arrow53/RoomTempHumidity/BaseUnitCase/snapshot-revision-B/enclosed-preview.png

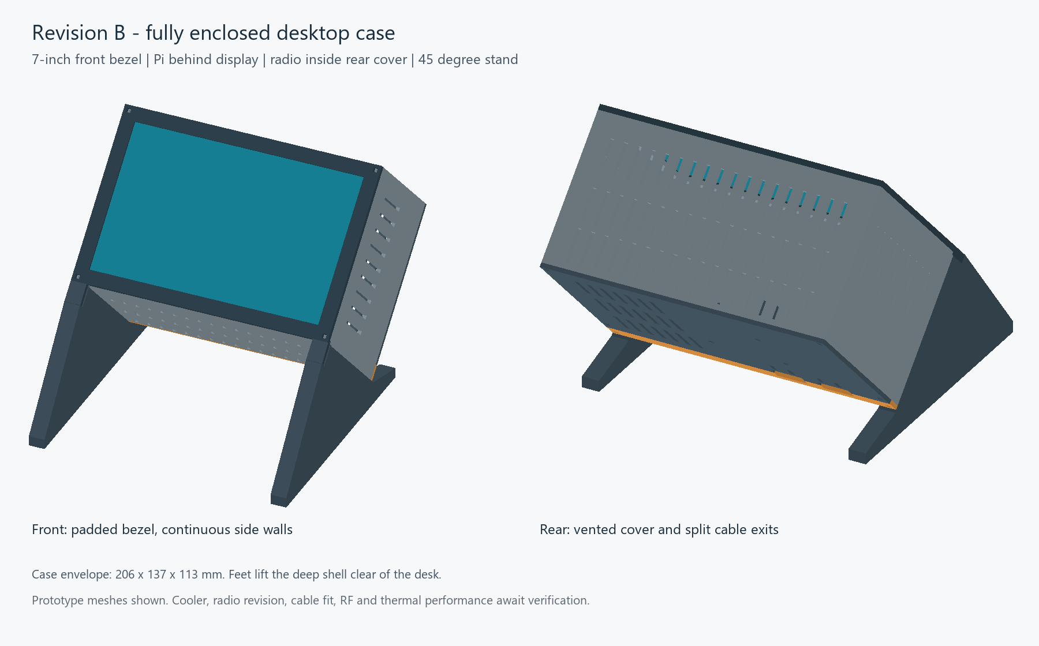
BaseUnitCase/snapshot-revision-B/enclosed-preview.png
