arrow53/RoomTempHumidity/docs/images/sensor-pcb-A3-copper.png

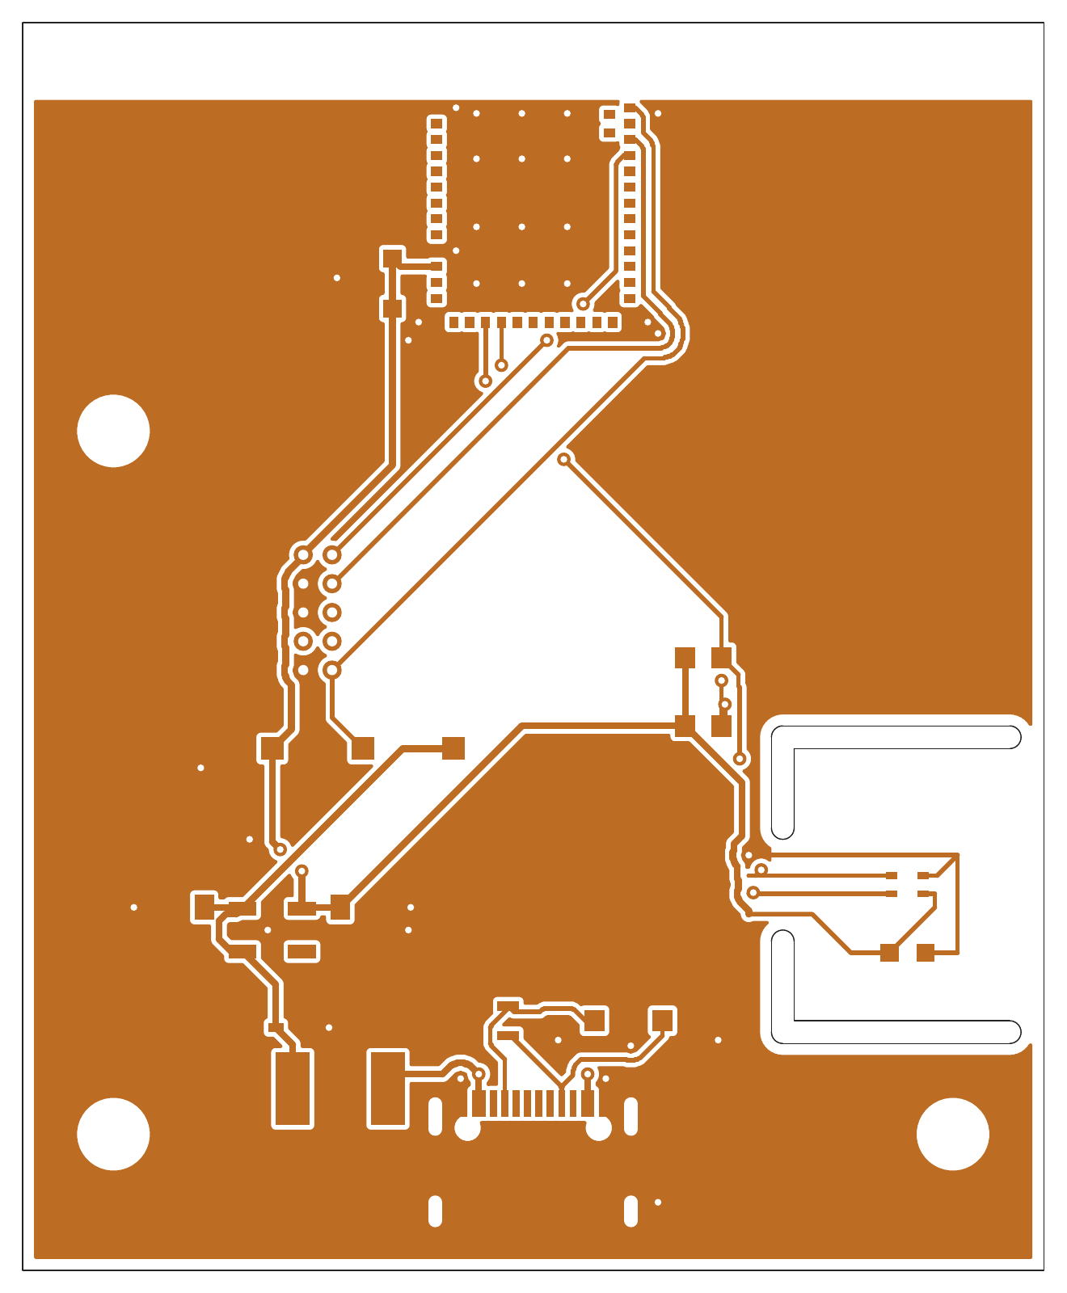
docs/images/sensor-pcb-A3-copper.png
