arrow53/RoomTempHumidity/SensorCase/concept_reference.png

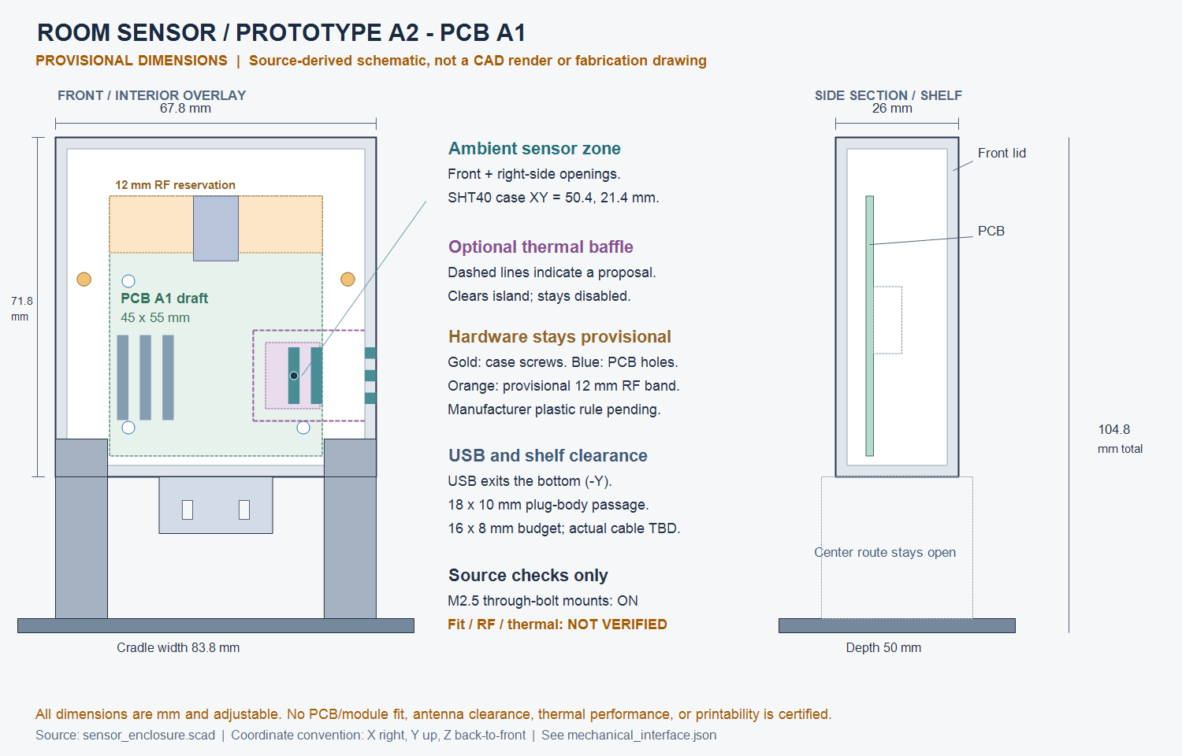
SensorCase/concept_reference.png
