arrow53/RoomTempHumidity/SensorPCB/assembly/BOM-10-boards.csv

Designator | Quantity per board | Quantity for 10 boards | Value / description | Manufacturer | Manufacturer Part Number | Package | Type | Allowed substitutions | Source | Notes
C1 | 1 | 10 | 2.2uF 25V X7R | TDK | C2012X7R1E225K125AB | 0805 | SMT | None; written engineering review required for changes. | https://product.tdk.com/en/search/capacitor/ceramic/mlcc/info?part_no=C2012X7R1E225K125AB | Exact MPN retained after source-based derating screen; see POWER_REVIEW.pdf. First-article startup/transient validation remains.
C2 | 1 | 10 | 4.7uF 10V X7R | TDK | C2012X7R1A475K125AC | 0805 | SMT | None; written engineering review required for changes. | https://product.tdk.com/en/search/capacitor/ceramic/mlcc/info?part_no=C2012X7R1A475K125AC | Exact MPN retained after source-based derating screen; see POWER_REVIEW.pdf. First-article startup/transient validation remains.
C3 | 1 | 10 | 1uF 16V X7R | TDK | C1608X7R1C105K080AC | 0603 | SMT | None; written engineering review required for changes. | https://product.tdk.com/en/search/capacitor/ceramic/mlcc/info?part_no=C1608X7R1C105K080AC | Exact MPN retained after source-based derating screen; see POWER_REVIEW.pdf. First-article startup/transient validation remains.
C4 | 1 | 10 | 100nF 50V X7R | TDK | C1608X7R1H104K080AA | 0603 | SMT | None; written engineering review required for changes. | https://product.tdk.com/en/search/capacitor/ceramic/mlcc/info?part_no=C1608X7R1H104K080AA | Exact MPN retained after source-based derating screen; see POWER_REVIEW.pdf. First-article startup/transient validation remains.
C5 | 1 | 10 | 100nF 50V X7R | TDK | C1608X7R1H104K080AA | 0603 | SMT | None; written engineering review required for changes. | https://product.tdk.com/en/search/capacitor/ceramic/mlcc/info?part_no=C1608X7R1H104K080AA | Exact MPN retained after source-based derating screen; see POWER_REVIEW.pdf. First-article startup/transient validation remains.
D1 | 1 | 10 | TPD1E10B06DYAR | Texas Instruments | TPD1E10B06DYAR | SOD-523 DYA | SMT | None; written engineering review required for changes. | https://www.ti.com/lit/ds/symlink/tpd1e10b06.pdf | 5.5 V standoff; max 14 V clamp at stated 5 A surge test. Verify ESD layout and inrush.
F1 | 1 | 10 | 200mA hold PTC | Bourns | MF-MSMF020-2 | 1812 | SMT | None; written engineering review required for changes. | https://www.bourns.com/docs/product-datasheets/mfmsmf.pdf | 200 mA hold, 30 V; check temperature derating and voltage drop. Not a precise current limiter.
J1 | 1 | 10 | USB4105-GF-A | GCT | USB4105-GF-A | USB-C receptacle, SMT signals plus four plated slotted anchors | SMT + PTH anchors | None; written engineering review required for changes. | https://gct.co/files/drawings/usb4105.pdf | Four common contact pairs use combined pad names; unused data/SBU NC.
R1 | 1 | 10 | 5.1k 1% | YAGEO | RC0603FR-075K1L | 0603 | SMT | None; written engineering review required for changes. | https://yageogroup.com/component-documentation/download/specsheet/RC0603FR-075K1L | USB-C Rd
R2 | 1 | 10 | 5.1k 1% | YAGEO | RC0603FR-075K1L | 0603 | SMT | None; written engineering review required for changes. | https://yageogroup.com/component-documentation/download/specsheet/RC0603FR-075K1L | USB-C Rd
R3 | 1 | 10 | 10k 1% | YAGEO | RC0603FR-0710KL | 0603 | SMT | None; written engineering review required for changes. | https://yageogroup.com/component-documentation/download/specsheet/RC0603FR-0710KL | 100 kHz bus, <=100 pF target
R4 | 1 | 10 | 10k 1% | YAGEO | RC0603FR-0710KL | 0603 | SMT | None; written engineering review required for changes. | https://yageogroup.com/component-documentation/download/specsheet/RC0603FR-0710KL | 100 kHz bus, <=100 pF target
U1 | 1 | 10 | AN54LQ-P15 | Raytac | MD-240A8-002 | 9.5x13.7 mm LGA module, PCB antenna | SMT | MD-240A8-002A or MD-240A8-002R: same AN54LQ-P15, packaging only; no AN54LQ-P10/P05, AN54LV, U15, or preprogrammed AT substitute. | https://www.raytac.com/download/index.php?index_id=74 | Internal LFRC and LDO configuration required. All omitted GPIO, DECD and DCC intentionally NC. Source ten genuine traceable modules; quote feeder attrition separately, not an assumed full tray/reel purchase.
U2 | 1 | 10 | SHT40-AD1B-R3 | Sensirion | SHT40-AD1B-R3 | DFN-4 1.5x1.5 mm | SMT | SHT40-AD1B-R2: same AD1B silicon and 0x44 address, reel quantity only; no -F/-P cover or other grade substitute. | https://sensirion.com/media/documents/33FD6951/6A7C10A0/HT_DS_Datasheet_SHT4x_V7.3.pdf | No central copper pad. No heater during normal measurements.
U3 | 1 | 10 | LT1761-3.3 | Analog Devices | LT1761IS5-3.3#TRMPBF | S5 TSOT-23-5, 1.00 mm max height | SMT | LT1761IS5-3.3#TRPBF, packaging only; genuine Analog Devices only. No E grade, adjustable, voltage or manufacturer substitutions. | https://www.analog.com/en/products/lt1761.html | A3: reverse-current-protected fixed 3.3 V. IN1/GND2/SHDN3/BYP4/OUT5; SHDN tied IN, BYP open. 50 mA design load budget; verify input headroom. Quote/DFM only.
U4 | 1 | 10 | TPD2E2U06DCKR | Texas Instruments | TPD2E2U06DCKR | SC70-3 DCK | SMT | None; written engineering review required for changes. | https://www.ti.com/lit/ds/symlink/tpd2e2u06.pdf | Place next to connector. CC1 and CC2 remain independent.
