arrow53/RoomTempHumidity/SensorPCB/editable/pin-net-review.csv

Reference | Pin | Function | Net
C1 | 1 | 1_1 | /VBUS_FUSED
C1 | 2 | 2_2 | /GND
C2 | 1 | 1_1 | /+3V3
C2 | 2 | 2_2 | /GND
C3 | 1 | 1_1 | /+3V3
C3 | 2 | 2_2 | /GND
C4 | 1 | 1_1 | /+3V3
C4 | 2 | 2_2 | /GND
C5 | 1 | 1_1 | /+3V3
C5 | 2 | 2_2 | /GND
D1 | 1 | IO_1 | /VBUS_FUSED
D1 | 2 | GND_2 | /GND
F1 | 1 | IN_1 | /VBUS_RAW
F1 | 2 | OUT_2 | /VBUS_FUSED
J1 | A1_B12 | GND_A1_B12 | /GND
J1 | A4_B9 | VBUS_A4_B9 | /VBUS_RAW
J1 | A5 | CC1_A5 | /CC1
J1 | A6 | D+_A6 | unconnected-(J1-D+-PadA6)
J1 | A7 | D-_A7 | unconnected-(J1-D--PadA7)
J1 | A8 | SBU1_A8 | unconnected-(J1-SBU1-PadA8)
J1 | B1_A12 | GND_B1_A12 | /GND
J1 | B4_A9 | VBUS_B4_A9 | /VBUS_RAW
J1 | B5 | CC2_B5 | /CC2
J1 | B6 | D+_B6 | unconnected-(J1-D+-PadB6)
J1 | B7 | D-_B7 | unconnected-(J1-D--PadB7)
J1 | B8 | SBU2_B8 | unconnected-(J1-SBU2-PadB8)
J1 | S1 | SHELL_S1 | /GND
J2 | 1 | VTREF_1 | /+3V3
J2 | 10 | RESET_N_10 | /RESET_N
J2 | 2 | SWDIO_2 | /SWDIO
J2 | 3 | GND_3 | /GND
J2 | 4 | SWDCLK_4 | /SWDCLK
J2 | 5 | GND_5 | /GND
J2 | 6 | SWO_NC_6 | unconnected-(J2-SWO_NC-Pad6)
J2 | 7 | KEY_NC_7 | unconnected-(J2-KEY_NC-Pad7)
J2 | 8 | NC_8 | unconnected-(J2-NC-Pad8)
J2 | 9 | GND_DETECT_9 | /GND
R1 | 1 | 1_1 | /CC1
R1 | 2 | 2_2 | /GND
R2 | 1 | 1_1 | /CC2
R2 | 2 | 2_2 | /GND
R3 | 1 | 1_1 | /+3V3
R3 | 2 | 2_2 | /I2C_SCL
R4 | 1 | 1_1 | /+3V3
R4 | 2 | 2_2 | /I2C_SDA
TP1 | 1 | TEST_1 | /GND
TP2 | 1 | TEST_1 | /+3V3
TP3 | 1 | TEST_1 | /RESET_N
TP4 | 1 | TEST_1 | /VBUS_FUSED
U1 | 1 | GND_1 | /GND
U1 | 10 | GND_10 | /GND
U1 | 11 | VDD_NRF_11 | /+3V3
U1 | 12 | P1.00_XL1_12 | unconnected-(U1-P1.00_XL1-Pad12)
U1 | 13 | P1.01_XL2_13 | unconnected-(U1-P1.01_XL2-Pad13)
U1 | 14 | GND_14 | /GND
U1 | 15 | P1.02_NFC1_15 | unconnected-(U1-P1.02_NFC1-Pad15)
U1 | 16 | P1.03_NFC2_16 | unconnected-(U1-P1.03_NFC2-Pad16)
U1 | 17 | P1.04_17 | /I2C_SCL
U1 | 18 | P1.05_18 | /I2C_SDA
U1 | 19 | P1.06_19 | unconnected-(U1-P1.06-Pad19)
U1 | 2 | P1.09_2 | unconnected-(U1-P1.09-Pad2)
U1 | 20 | P1.07_20 | unconnected-(U1-P1.07-Pad20)
U1 | 21 | P1.08_21 | unconnected-(U1-P1.08-Pad21)
U1 | 22 | P2.00_22 | unconnected-(U1-P2.00-Pad22)
U1 | 23 | P2.01_23 | unconnected-(U1-P2.01-Pad23)
U1 | 24 | P2.02_24 | unconnected-(U1-P2.02-Pad24)
U1 | 25 | P2.03_25 | unconnected-(U1-P2.03-Pad25)
U1 | 26 | GND_26 | /GND
U1 | 27 | P2.04_27 | unconnected-(U1-P2.04-Pad27)
U1 | 28 | P2.05_28 | unconnected-(U1-P2.05-Pad28)
U1 | 29 | P2.06_29 | unconnected-(U1-P2.06-Pad29)
U1 | 3 | P1.10_3 | unconnected-(U1-P1.10-Pad3)
U1 | 30 | P2.07_30 | unconnected-(U1-P2.07-Pad30)
U1 | 31 | P2.08_31 | unconnected-(U1-P2.08-Pad31)
U1 | 32 | P2.09_32 | unconnected-(U1-P2.09-Pad32)
U1 | 33 | P2.10_33 | unconnected-(U1-P2.10-Pad33)
U1 | 34 | P0.00_34 | unconnected-(U1-P0.00-Pad34)
U1 | 35 | P0.01_35 | unconnected-(U1-P0.01-Pad35)
U1 | 36 | SWDIO_36 | /SWDIO
U1 | 37 | SWDCLK_37 | /SWDCLK
U1 | 38 | P0.03_38 | unconnected-(U1-P0.03-Pad38)
U1 | 39 | RESET_N_39 | /RESET_N
U1 | 4 | P1.11_4 | unconnected-(U1-P1.11-Pad4)
U1 | 40 | P0.04_40 | unconnected-(U1-P0.04-Pad40)
U1 | 41 | P0.02_41 | unconnected-(U1-P0.02-Pad41)
U1 | 5 | P1.12_5 | unconnected-(U1-P1.12-Pad5)
U1 | 6 | P1.13_6 | unconnected-(U1-P1.13-Pad6)
U1 | 7 | P1.14_7 | unconnected-(U1-P1.14-Pad7)
U1 | 8 | DECD_8 | unconnected-(U1-DECD-Pad8)
U1 | 9 | DCC_9 | unconnected-(U1-DCC-Pad9)
U2 | 1 | SDA_1 | /I2C_SDA
U2 | 2 | SCL_2 | /I2C_SCL
U2 | 3 | VDD_3 | /+3V3
U2 | 4 | VSS_4 | /GND
U3 | 1 | IN_1 | /VBUS_FUSED
U3 | 2 | GND_2 | /GND
U3 | 3 | SHDN_3 | /VBUS_FUSED
U3 | 4 | BYP_4 | unconnected-(U3-BYP-Pad4)
U3 | 5 | OUT_5 | /+3V3
U4 | 1 | IO1_1 | /CC1
U4 | 2 | IO2_2 | /CC2
U4 | 3 | GND_3 | /GND
