arrow53/RoomTempHumidity/BaseUnitCase/revision-C/assembled_enclosure.step

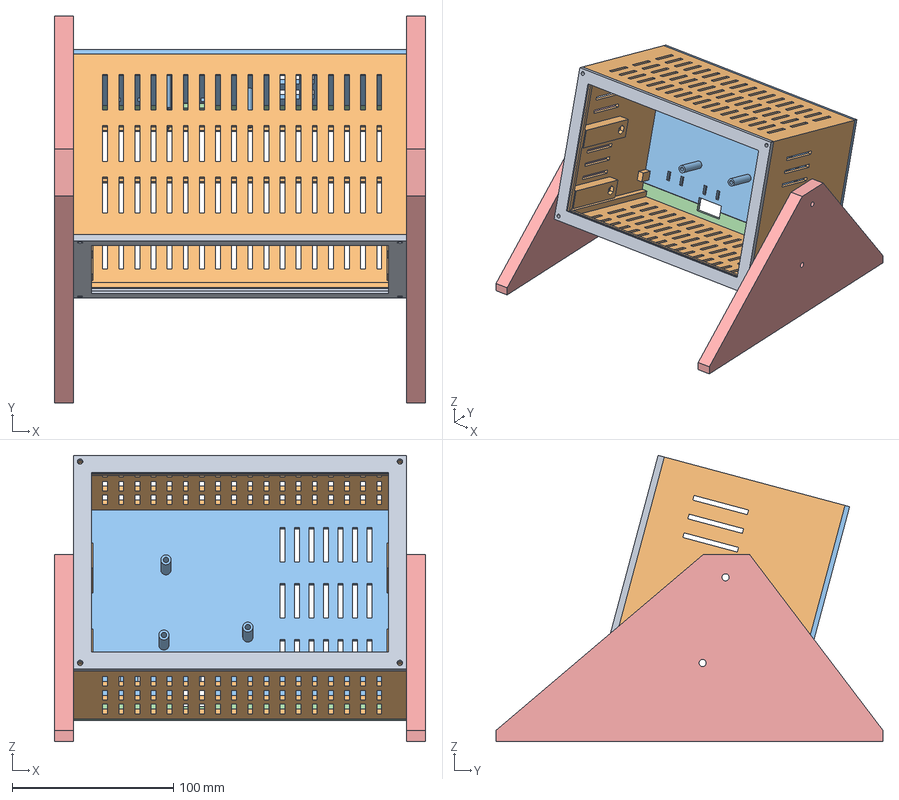
[picture p8: CAD file, 2026-10-11]
BaseUnitCase/revision-C/assembled_enclosure.step
230.3 x 240.0 x 177.6 mm
