arrow53/RoomTempHumidity/BaseUnitCase/revision-C/side_stand_print_two.step

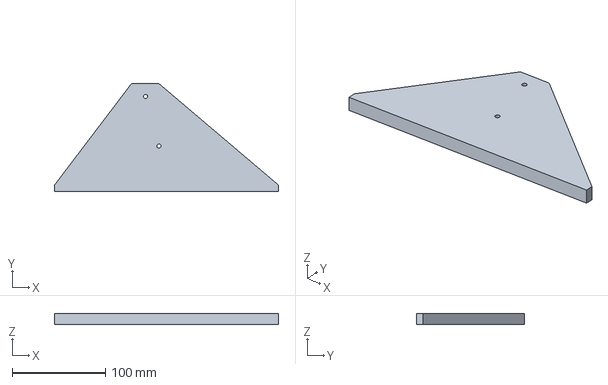
[picture p9: CAD file, 2026-10-11]
BaseUnitCase/revision-C/side_stand_print_two.step
240.0 x 115.9 x 12.0 mm
