arrow53/RoomTempHumidity/BaseUnitCase/snapshot-revision-B/feet_45_print_two.stl

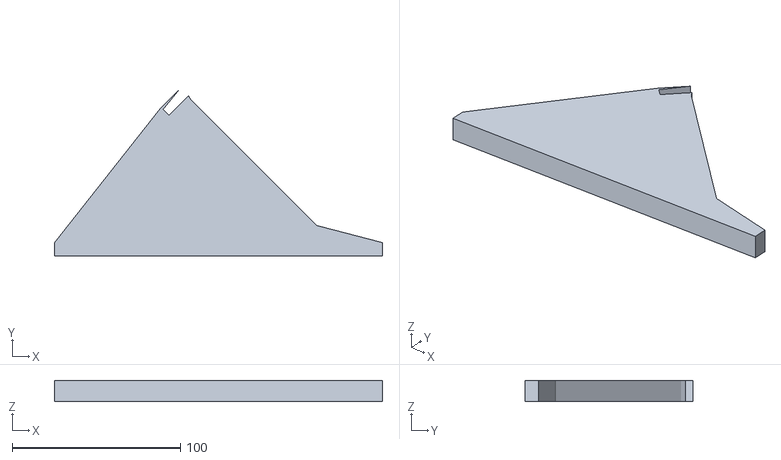
[picture p10: CAD file, 2026-10-11]
BaseUnitCase/snapshot-revision-B/feet_45_print_two.stl
195.0 x 100.0 x 12.6
