arrow53/RoomTempHumidity/SensorCase/fit_coupons/usb_wall_PROVISIONAL.stl

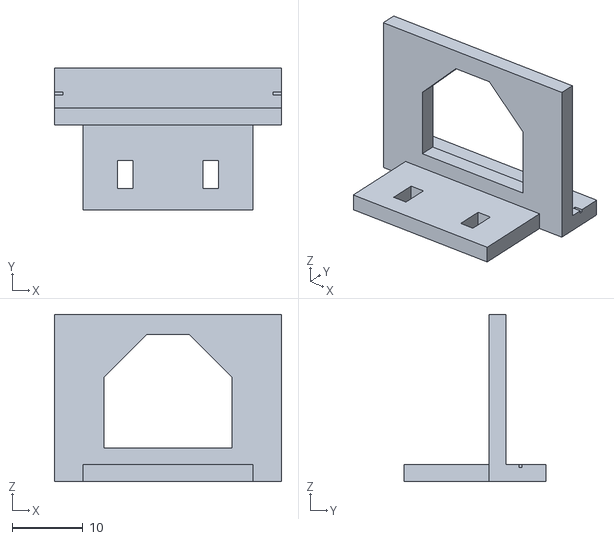
[picture p11: CAD file, 2026-10-11]
SensorCase/fit_coupons/usb_wall_PROVISIONAL.stl
32.0 x 20.0 x 23.6
