arrow53/RoomTempHumidity/SensorCase/provisional_cad/lid_PROVISIONAL.stl

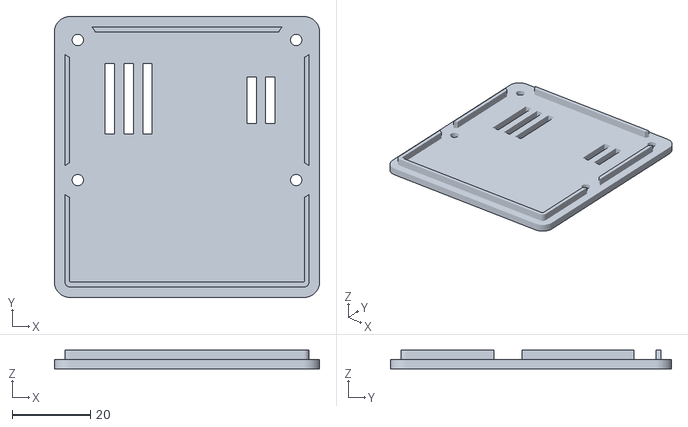
[picture p12: CAD file, 2026-10-11]
SensorCase/provisional_cad/lid_PROVISIONAL.stl
67.8 x 71.8 x 4.80
