arrow53/RoomTempHumidity/BaseUnitCase/revision-C/fastener_coupon.step

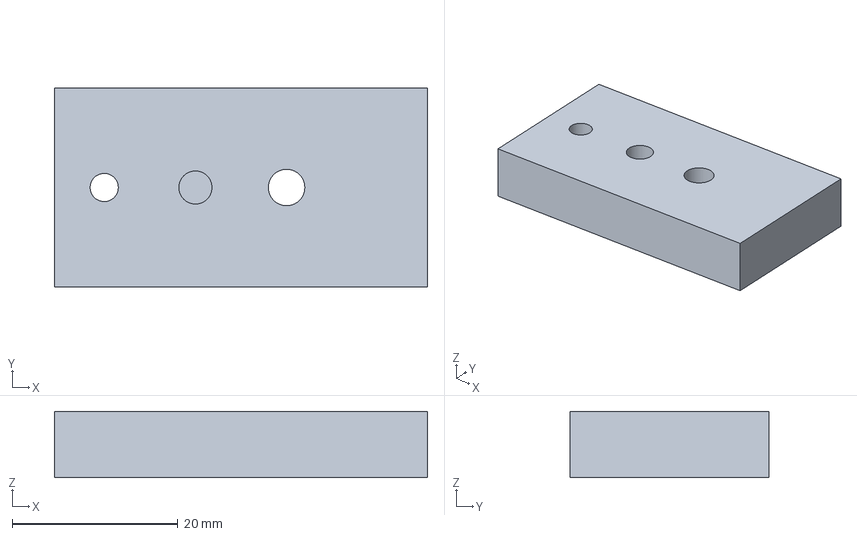
[picture p13: CAD file, 2026-10-11]
BaseUnitCase/revision-C/fastener_coupon.step
45.0 x 24.0 x 8.00 mm
