arrow53/RoomTempHumidity/BaseUnitCase/snapshot-revision-B/rear_cover_radio_mount.stl

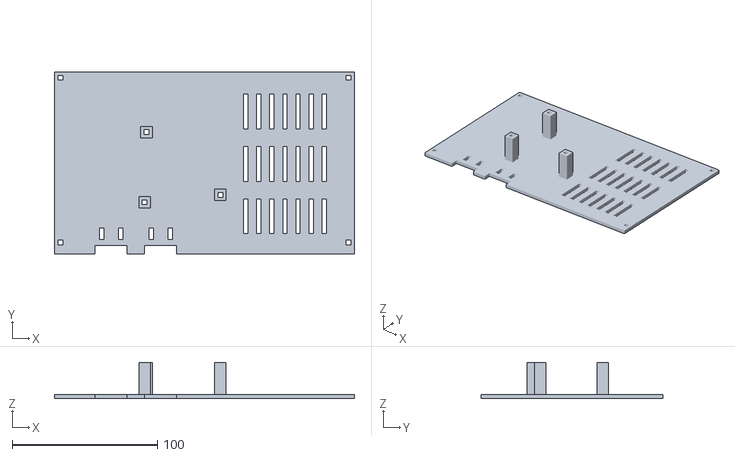
[picture p14: CAD file, 2026-10-11]
BaseUnitCase/snapshot-revision-B/rear_cover_radio_mount.stl
206.3 x 125.2 x 25.0
