arrow53/RoomTempHumidity/SensorCase/fit_coupons/pcb_shim_PROVISIONAL.stl

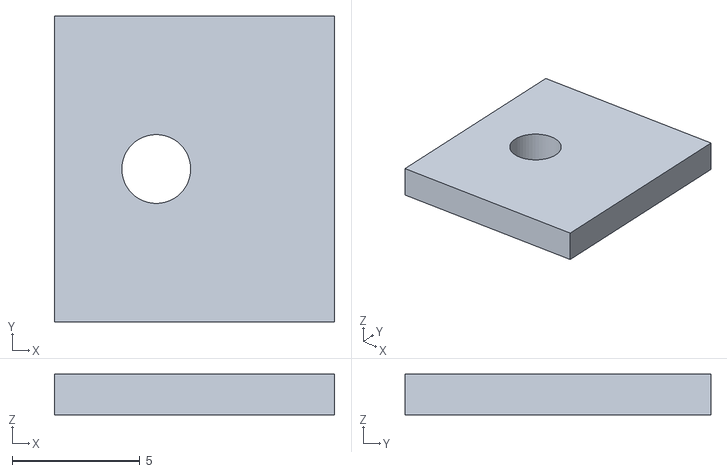
[picture p15: CAD file, 2026-10-11]
SensorCase/fit_coupons/pcb_shim_PROVISIONAL.stl
11.0 x 12.0 x 1.60
