arrow53/RoomTempHumidity/SensorCase/provisional_cad/wall_spacer_PROVISIONAL.stl

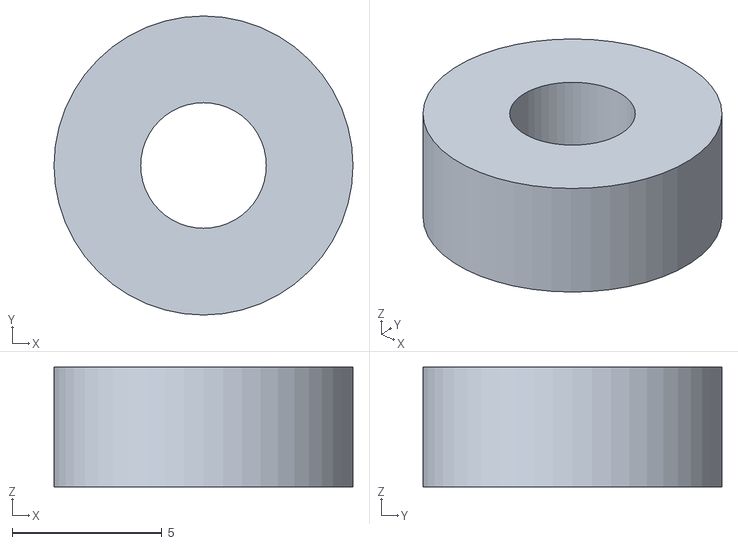
[picture p16: CAD file, 2026-10-11]
SensorCase/provisional_cad/wall_spacer_PROVISIONAL.stl
10.0 x 10.0 x 4.00
