arrow53/RoomTempHumidity/BaseUnitCase/revision-C/hardware_clearance_PROXIES.step

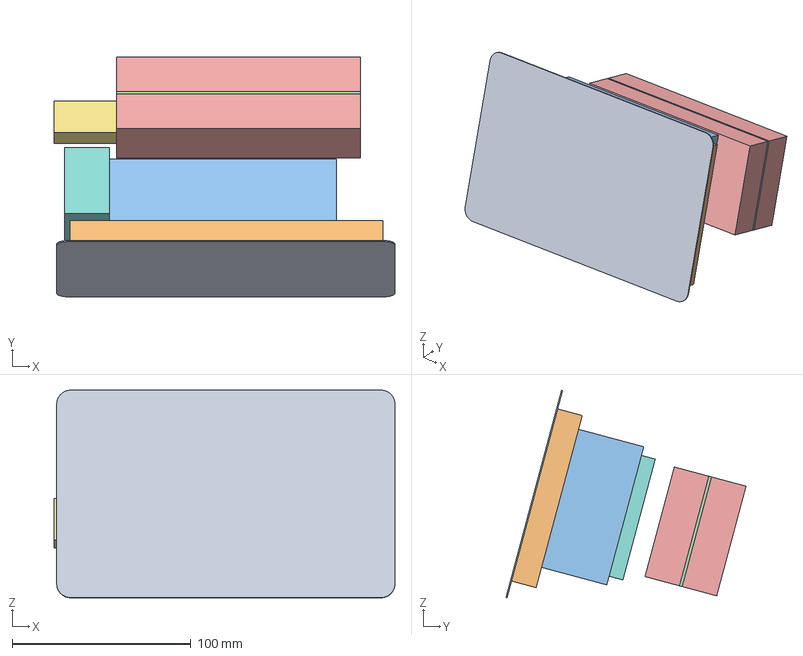
[picture p17: CAD file, 2026-10-11]
BaseUnitCase/revision-C/hardware_clearance_PROXIES.step
190.8 x 134.4 x 116.3 mm
