arrow53/RoomTempHumidity/BaseUnitCase/snapshot-revision-B/rear_cable_strip.stl

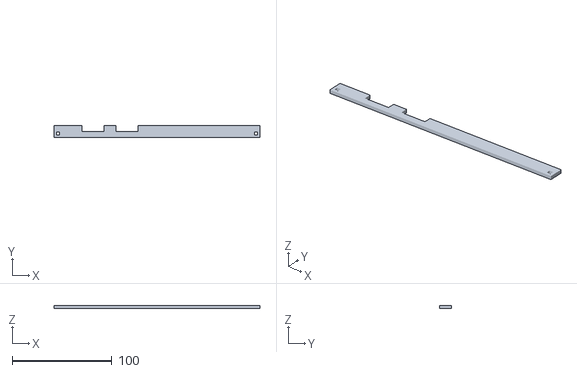
[picture p18: CAD file, 2026-10-11]
BaseUnitCase/snapshot-revision-B/rear_cable_strip.stl
206.3 x 12.0 x 3.00
