arrow53/RoomTempHumidity/SensorCase/fit_coupons/case_lid_PROVISIONAL.stl

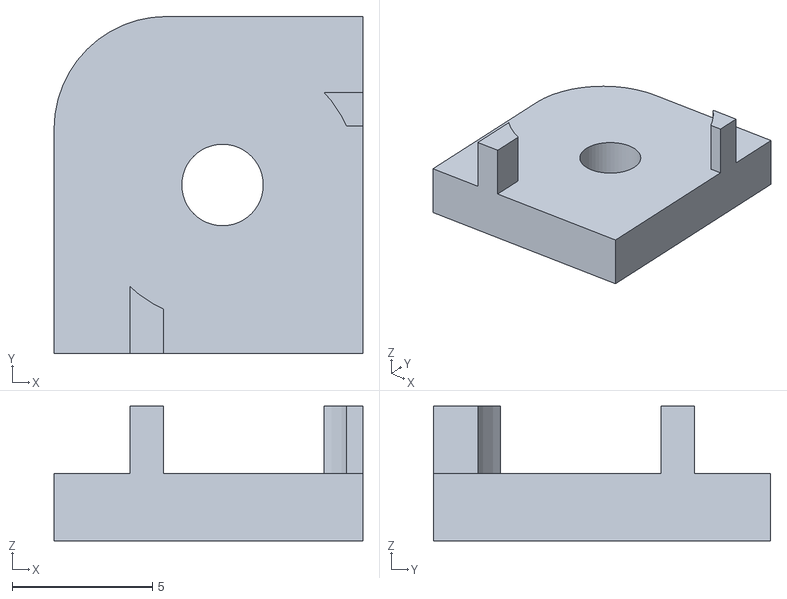
[picture p19: CAD file, 2026-10-11]
SensorCase/fit_coupons/case_lid_PROVISIONAL.stl
11.0 x 12.0 x 4.80
