arrow53/RoomTempHumidity/SensorCase/provisional_cad/stand_PROVISIONAL.stl

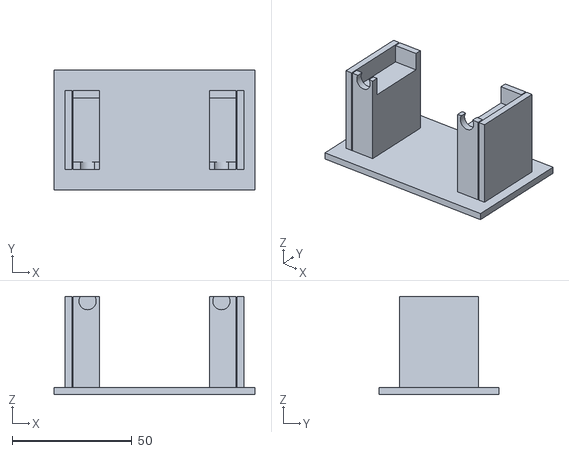
[picture p20: CAD file, 2026-10-11]
SensorCase/provisional_cad/stand_PROVISIONAL.stl
83.8 x 50.0 x 41.0
