arrow53/RoomTempHumidity/BaseUnitCase/revision-C/rear_cover_radio_mount.step

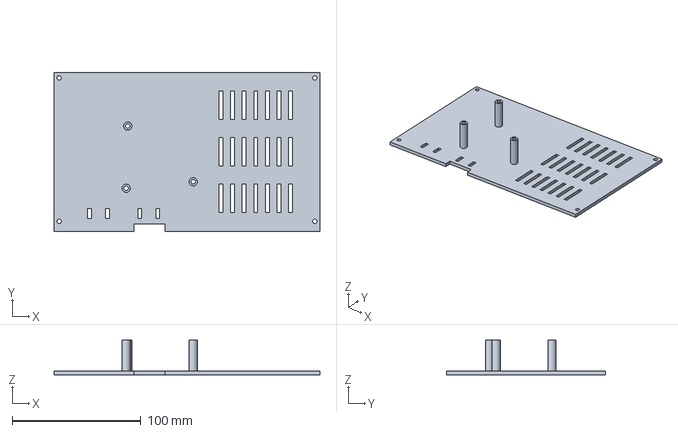
[picture p21: CAD file, 2026-10-11]
BaseUnitCase/revision-C/rear_cover_radio_mount.step
206.3 x 122.9 x 27.0 mm
