arrow53/RoomTempHumidity/BaseUnitCase/snapshot-revision-B/enclosed_body.stl

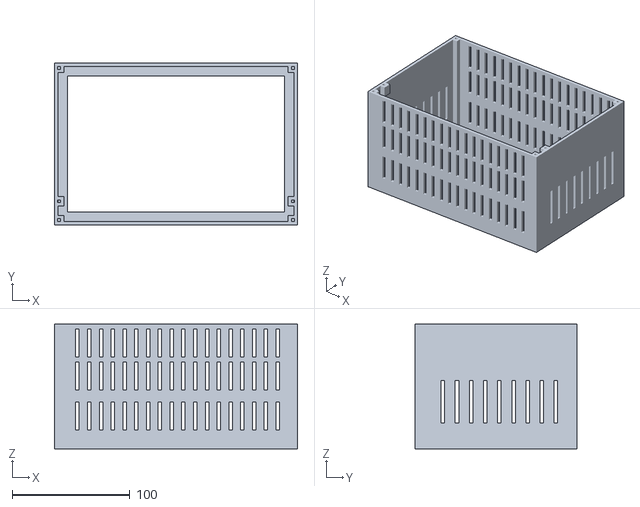
[picture p22: CAD file, 2026-10-11]
BaseUnitCase/snapshot-revision-B/enclosed_body.stl
206.3 x 137.2 x 106.0
