arrow53/RoomTempHumidity/SensorCase/provisional_cad/coupon_PROVISIONAL.stl

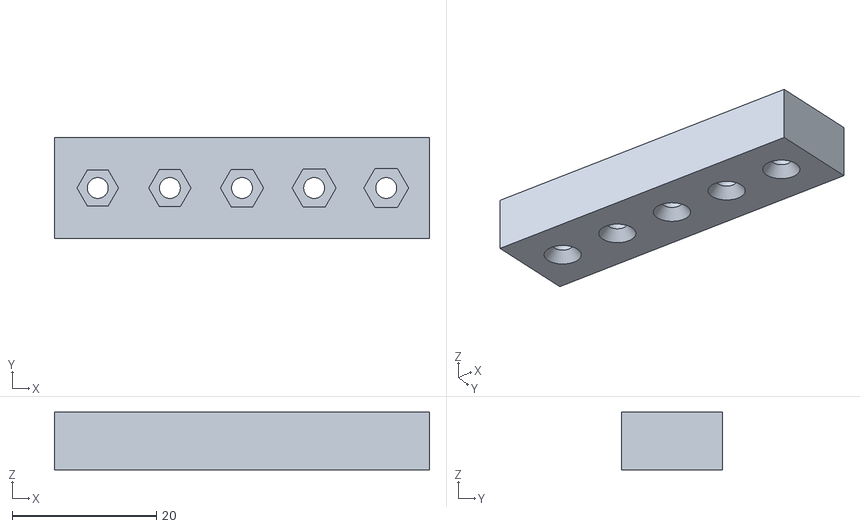
[picture p23: CAD file, 2026-10-11]
SensorCase/provisional_cad/coupon_PROVISIONAL.stl
52.0 x 14.0 x 8.00
