arrow53/RoomTempHumidity/BaseUnitCase/revision-C/front_bezel.step

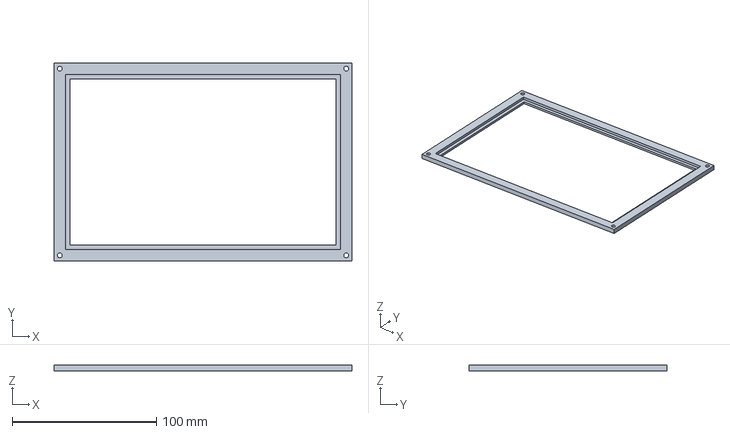
[picture p24: CAD file, 2026-10-11]
BaseUnitCase/revision-C/front_bezel.step
206.3 x 137.2 x 4.00 mm
