arrow53/RoomTempHumidity/BaseUnitCase/snapshot-revision-B/front_bezel.stl

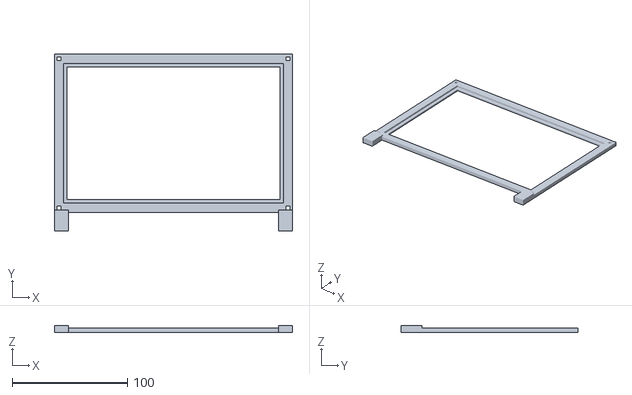
[picture p25: CAD file, 2026-10-11]
BaseUnitCase/snapshot-revision-B/front_bezel.stl
206.3 x 153.2 x 6.00
