arrow53/RoomTempHumidity/SensorCase/provisional_cad/base_PROVISIONAL.stl

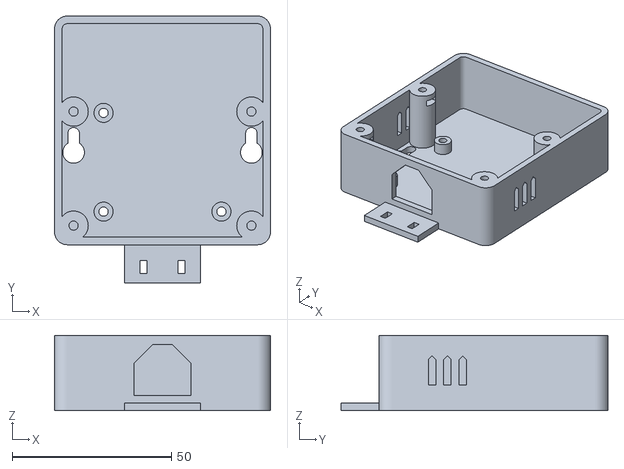
[picture p27: CAD file, 2026-10-11]
SensorCase/provisional_cad/base_PROVISIONAL.stl
67.8 x 83.8 x 23.6
