arrow53/RoomTempHumidity/BaseUnitCase/snapshot-revision-B/fit_coupon.stl

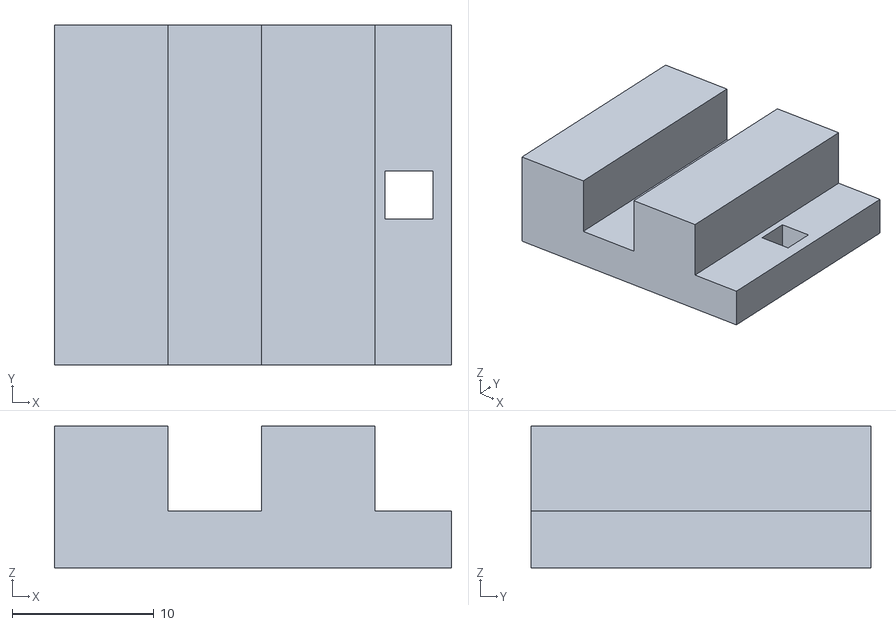
[picture p28: CAD file, 2026-10-11]
BaseUnitCase/snapshot-revision-B/fit_coupon.stl
28.0 x 24.0 x 10.0
