arrow53/RoomTempHumidity/BaseUnitCase/revision-C/vented_body.step

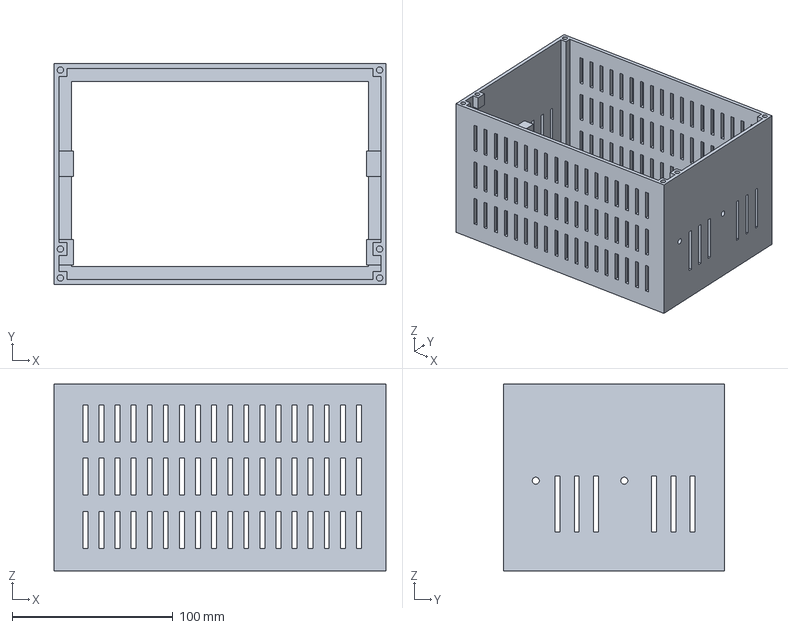
[picture p29: CAD file, 2026-10-11]
BaseUnitCase/revision-C/vented_body.step
206.3 x 137.2 x 116.0 mm
