arrow53/RoomTempHumidity/BaseUnitCase/revision-C/rear_cable_strip.step

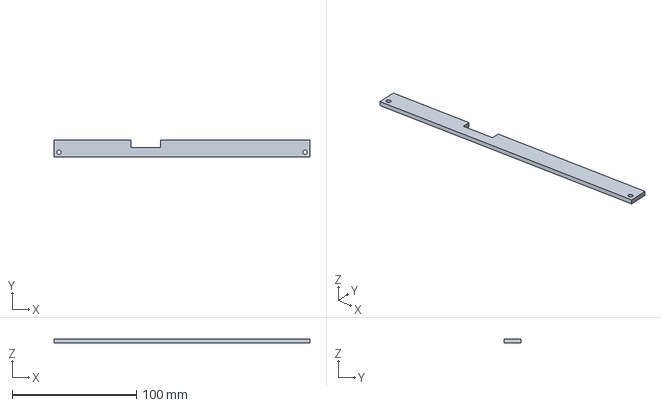
[picture p30: CAD file, 2026-10-11]
BaseUnitCase/revision-C/rear_cable_strip.step
206.3 x 14.0 x 3.00 mm
