arrow53/RoomTempHumidity/BaseUnitCase/snapshot-revision-B/enclosed_case.scad

// Revision B: enclosed, millimetres. Generated by enclosed_case.py
part="assembly";
module front_bezel(){difference(){union(){translate([0, 0, 0]) cube([206.32, 137.24, 4]);translate([0, -16, 0]) cube([12, 18, 6]);translate([194.32, -16, 0]) cube([12.0, 18, 6]);}union(){translate([11, 11, -1]) cube([184.32, 115.24, 8]);translate([8, 8, 1.8]) cube([190.32, 121.24, 8.0]);translate([2.3, 2.3, -1]) cube([3.4, 3.4, 9]);translate([200.62, 2.3, -1]) cube([3.4, 3.4, 9]);translate([2.3, 131.54000000000002, -1]) cube([3.4, 3.4, 9]);translate([200.62, 131.54000000000002, -1]) cube([3.4, 3.4, 9]);}}}
module enclosed_body(){difference(){union(){translate([0, 0, 0]) cube([206.32, 137.24, 3]);translate([0, 0, 0]) cube([3, 137.24, 106.0]);translate([203.32, 0, 0]) cube([3.0, 137.24, 106.0]);translate([0, 0, 0]) cube([206.32, 3, 106.0]);translate([0, 134.24, 0]) cube([206.32, 3.0, 106.0]);translate([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
module rear_cover_radio_mount(){difference(){union(){translate([0, 12, 0]) cube([206.32, 125.24, 3]);translate([57.97, 43.62, 3]) cube([8.0, 8.0, 22.0]);translate([59.24, 91.88, 3]) cube([8.0, 8.0, 22.0]);translate([110.04, 48.7, 3]) cube([8.0, 8.0, 22.0]);}union(){translate([2.3, 131.54000000000002, -1]) cube([3.4, 3.4, 5]);translate([200.62, 131.54000000000002, -1]) cube([3.4, 3.4, 5]);translate([2.3, 18.3, -1]) cube([3.4, 3.4, 5]);translate([200.62, 18.3, -1]) cube([3.4, 3.4, 5]);translate([60.269999999999996, 45.919999999999995, -1]) cube([3.4, 3.4, 27.0]);translate([61.54, 94.17999999999999, -1]) cube([3.4, 3.4, 27.0]);translate([112.34, 51.0, -1]) cube([3.4, 3.4, 27.0]);translate([130, 26, -1]) cube([3, 24, 5]);translate([130, 62, -1]) cube([3, 24, 5]);translate([130, 98, -1]) cube([3, 24, 5]);translate([139, 26, -1]) cube([3, 24, 5]);translate([139, 62, -1]) cube([3, 24, 5]);translate([139, 98, -1]) cube([3, 24, 5]);translate([148, 26, -1]) cube([3, 24, 5]);translate([148, 62, -1]) cube([3, 24, 5]);translate([148, 98, -1]) cube([3, 24, 5]);translate([157, 26, -1]) cube([3, 24, 5]);translate([157, 62, -1]) cube([3, 24, 5]);translate([157, 98, -1]) cube([3, 24, 5]);translate([166, 26, -1]) cube([3, 24, 5]);translate([166, 62, -1]) cube([3, 24, 5]);translate([166, 98, -1]) cube([3, 24, 5]);translate([175, 26, -1]) cube([3, 24, 5]);translate([175, 62, -1]) cube([3, 24, 5]);translate([175, 98, -1]) cube([3, 24, 5]);translate([184, 26, -1]) cube([3, 24, 5]);translate([184, 62, -1]) cube([3, 24, 5]);translate([184, 98, -1]) cube([3, 24, 5]);translate([28, 11, -1]) cube([22, 7, 5]);translate([62, 11, -1]) cube([22, 7, 5]);translate([31, 22, -1]) cube([3, 8, 5]);translate([44, 22, -1]) cube([3, 8, 5]);translate([65, 22, -1]) cube([3, 8, 5]);translate([78, 22, -1]) cube([3, 8, 5]);}}}
module rear_cable_strip(){difference(){union(){translate([0, 0, 0]) cube([206.32, 12, 3]);}union(){translate([2.3, 2.3, -1]) cube([3.4, 3.4, 5]);translate([200.62, 2.3, -1]) cube([3.4, 3.4, 5]);translate([28, 6, -1]) cube([22, 7, 5]);translate([62, 6, -1]) cube([22, 7, 5]);}}}
module feet_45_print_two(){linear_extrude(12.6) polygon([(-45, 0), (150, 0), (150, 8), (110.78174593052023, 18.21825406947977), (36.08111831820431, 92.9188816817957), (34.66690475583121, 95.33309524416879), (23.070353544371834, 83.7365440327094), (18.403448788540622, 88.40344878854062), (30, 100), (-45, 8)]);}
module fit_coupon(){difference(){union(){translate([0, 0, 0]) cube([28, 24, 4]);translate([0, 0, 4]) cube([8, 24, 6]);translate([14.6, 0, 4]) cube([8.0, 24, 6]);}union(){translate([23.3, 10.3, -1]) cube([3.4, 3.4, 6]);}}}
if(part=="front_bezel") front_bezel();
if(part=="enclosed_body") enclosed_body();
if(part=="rear_cover_radio_mount") rear_cover_radio_mount();
if(part=="rear_cable_strip") rear_cable_strip();
if(part=="feet_45_print_two") feet_45_print_two();
if(part=="fit_coupon") fit_coupon();

module case_assembly(){
 color("slategray") front_bezel();
 color("gray") translate([0,0,4]) enclosed_body();
 color("slategray") translate([0,0,113]) mirror([0,0,1]) rear_cover_radio_mount();
 color("orange") translate([0,0,113]) mirror([0,0,1]) rear_cable_strip();
 color([.05,.25,.3,.5]) translate([8.5,8.5,2.3]) cube([189.32,120.24,.7]);
 // Hardware bounding envelopes are illustrative; precise Pi position unconfirmed.
 if(part=="cutaway"){
 color([0,.7,.2,.5]) translate([60,40,18]) cube([85,56,1.6]);
 color([.6,.6,.6,.5]) translate([70,44,20]) cube([63.5,42.5,13.7]);
 color([0,.7,.2,.5]) translate([48,40,86.4]) cube([136.525,63.5,1.6]);
 }
}
if(part=="assembly" || part=="cutaway"){
 translate([0,30,100]) multmatrix([[1,0,0,0],[0,.70710678,.70710678,0],[0,.70710678,-.70710678,0],[0,0,0,1]]) case_assembly();
 for(x=[0,194.32]) translate([x,0,0]) multmatrix([[0,0,1,0],[1,0,0,0],[0,1,0,0],[0,0,0,1]]) feet_45_print_two();
}
