arrow53/RoomTempHumidity/(list of files, cad)

Other CAD files:
SensorCase/fit_coupons/fit_coupons_generated.scad
SensorCase/provisional_cad/assembly_collision_checks.scad
BaseUnitCase/revision-C/fastener_coupon.stl
BaseUnitCase/revision-C/front_bezel.stl
BaseUnitCase/revision-C/rear_cable_strip.stl
BaseUnitCase/revision-C/rear_cover_radio_mount.stl
BaseUnitCase/revision-C/side_stand_print_two.stl
BaseUnitCase/revision-C/vented_body.stl
BaseUnitCase/snapshot-prototype-A/enclosure.scad
BaseUnitCase/snapshot-prototype-A/foot_45_print_two.stl
BaseUnitCase/snapshot-prototype-A/radio_dock.stl
BaseUnitCase/snapshot-prototype-A/retainer_bottom.stl
BaseUnitCase/snapshot-prototype-A/retainer_top.stl
SensorCase/fit_coupons/case_nut_PROVISIONAL.stl
