arrow53/RoomTempHumidity/SensorPCB/assembly/DNP-and-board-features.csv

Designators | Treatment | Notes
J2 | DNP | Ten plated SWD probe pads; no header purchased or fitted. Programming fixture/scope must be agreed.
TP1 TP2 TP3 TP4 H1 H2 H3 | PCB features | No purchased or placed parts.
