arrow53/RoomTempHumidity/BaseUnitCase/revision-C/assembled-rear-three-quarter.png

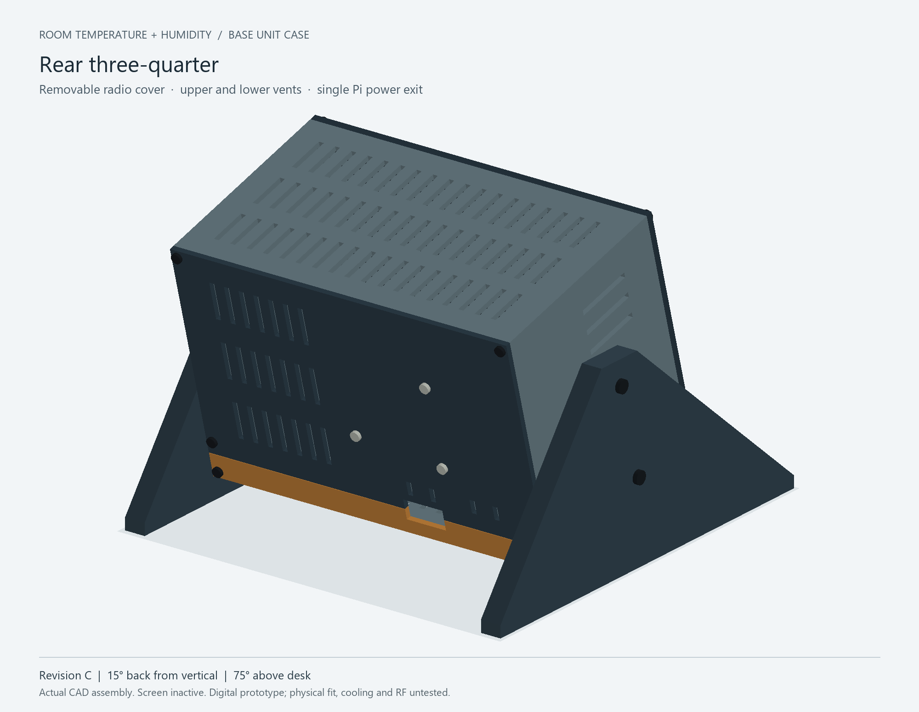
BaseUnitCase/revision-C/assembled-rear-three-quarter.png
