arrow53/RoomTempHumidity/BaseUnitCase/revision-C/assembled-side.png

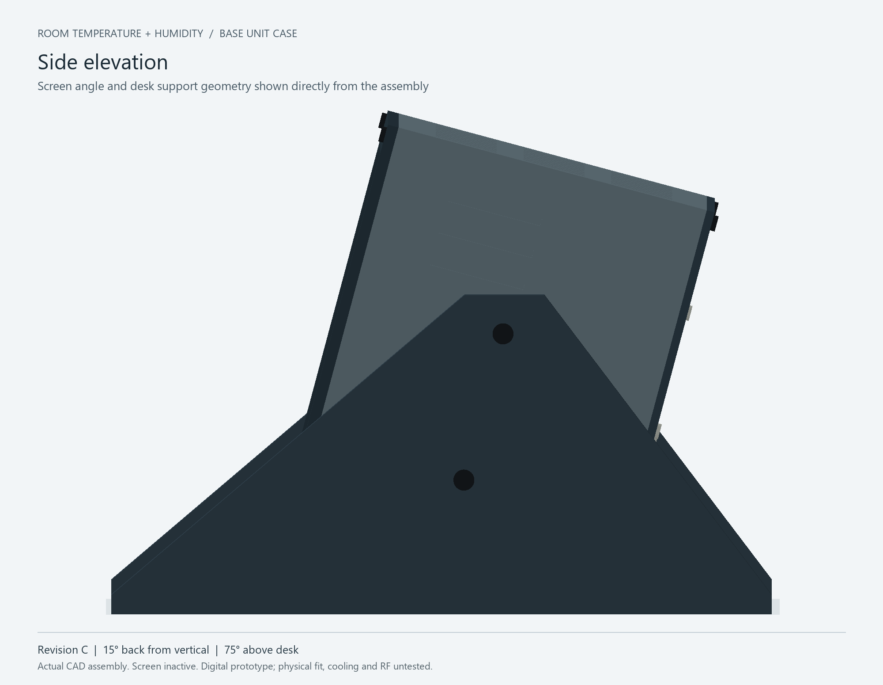
BaseUnitCase/revision-C/assembled-side.png
