arrow53/RoomTempHumidity/(list of files, drawings)

Other design files:
SensorCase/pcb_A1_mechanical_interface.json
