arrow53/RoomTempHumidity/SensorPCB/editable/room_sensor.kicad_pcb

## KiCad design SensorPCB/editable/room_sensor.kicad_pcb (2026-10-11)

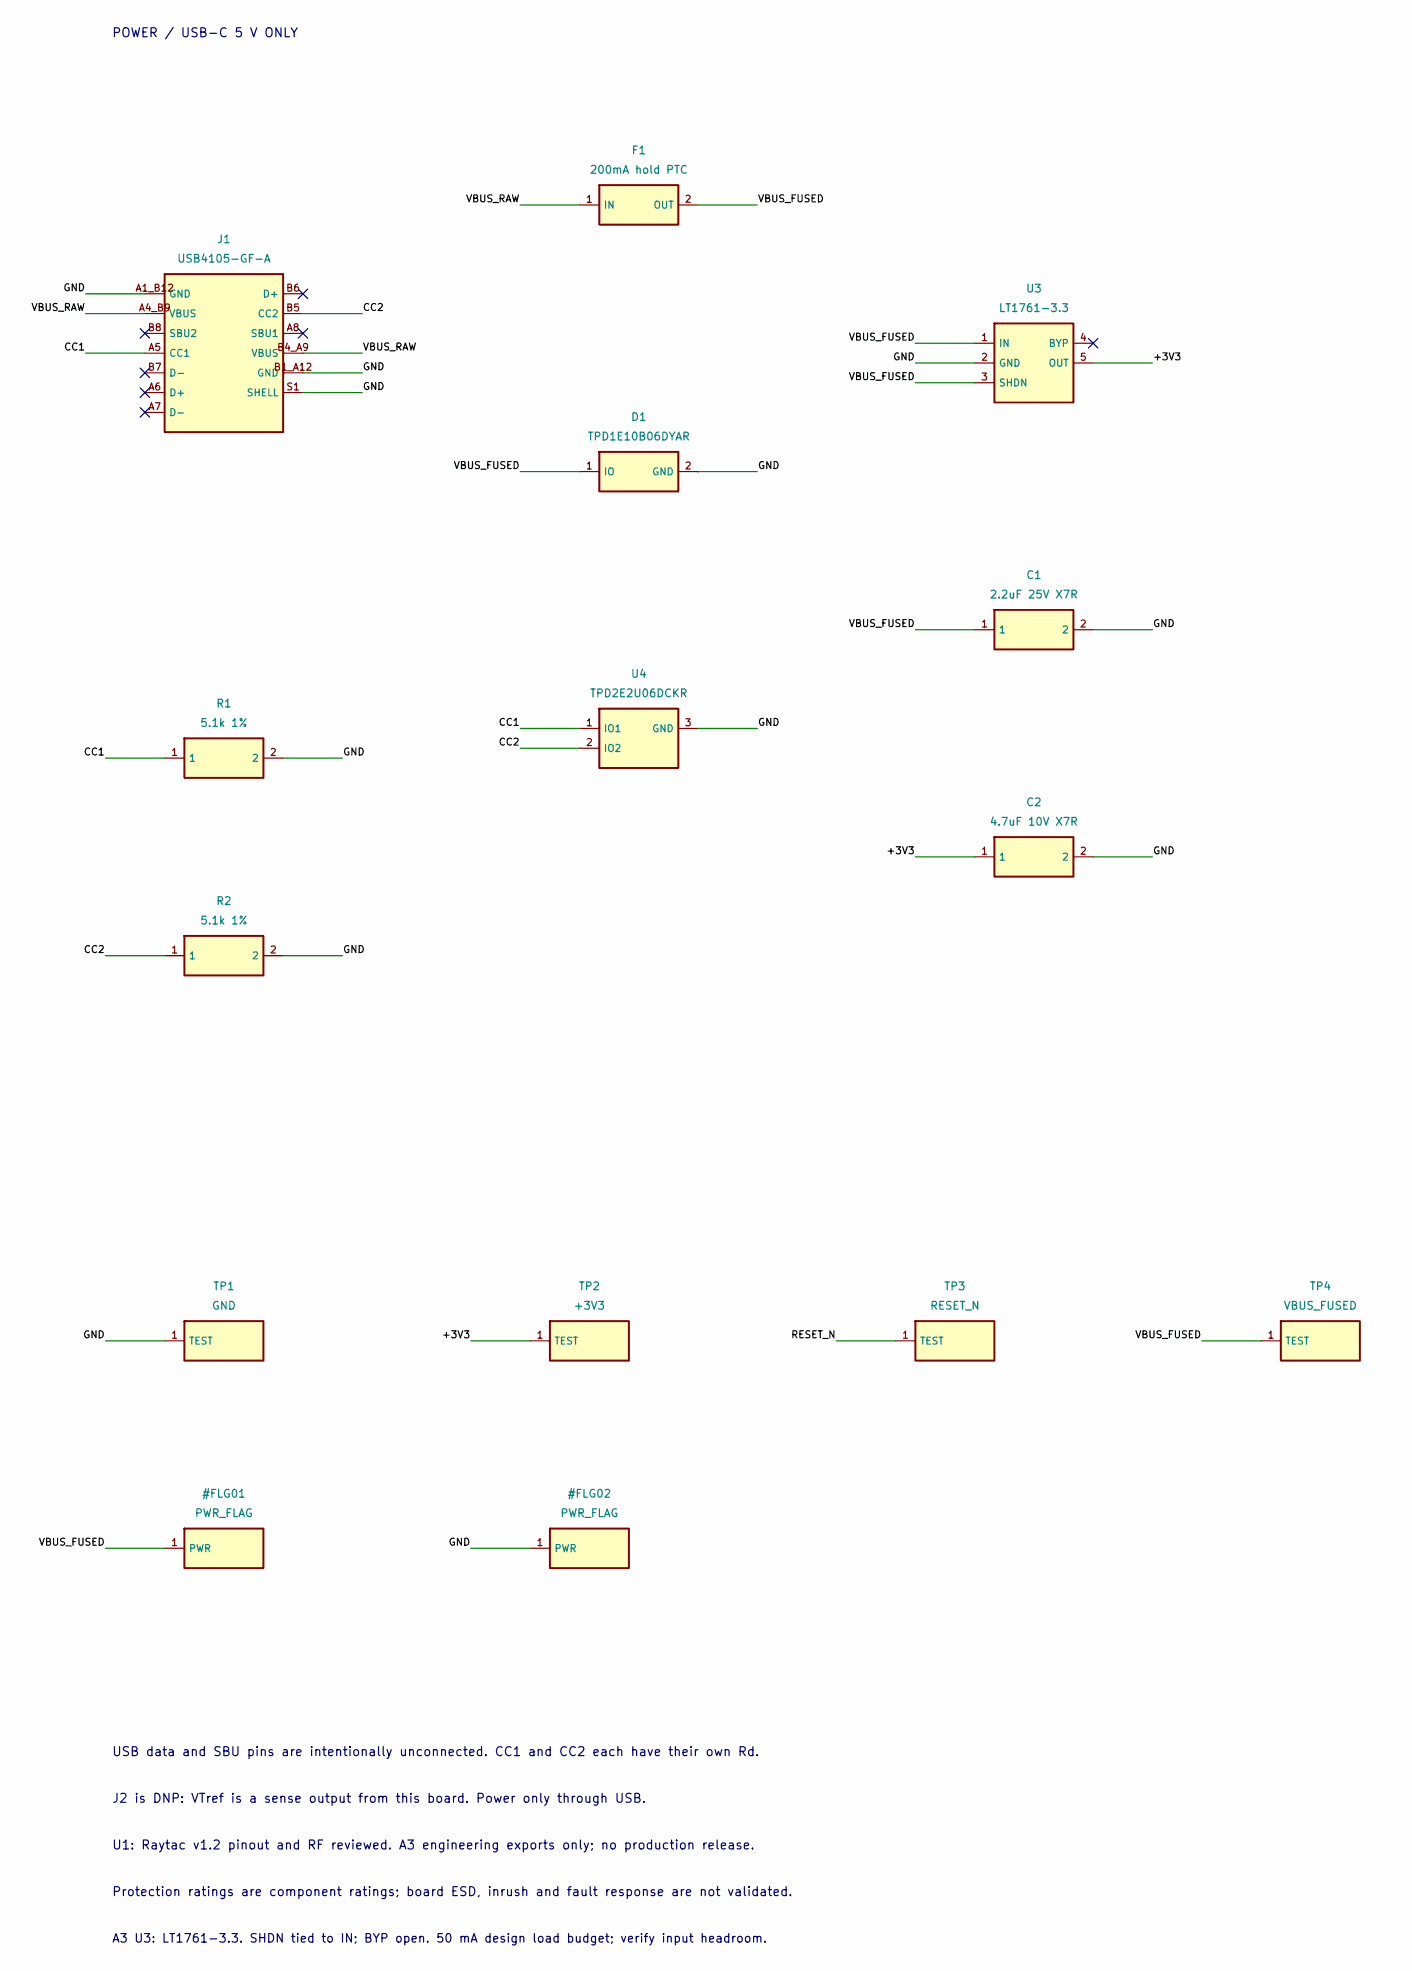
[picture p33: schematic room_sensor.kicad_sch, Room sensor A3 - protected power engineering draft, part in row 1, column 1]

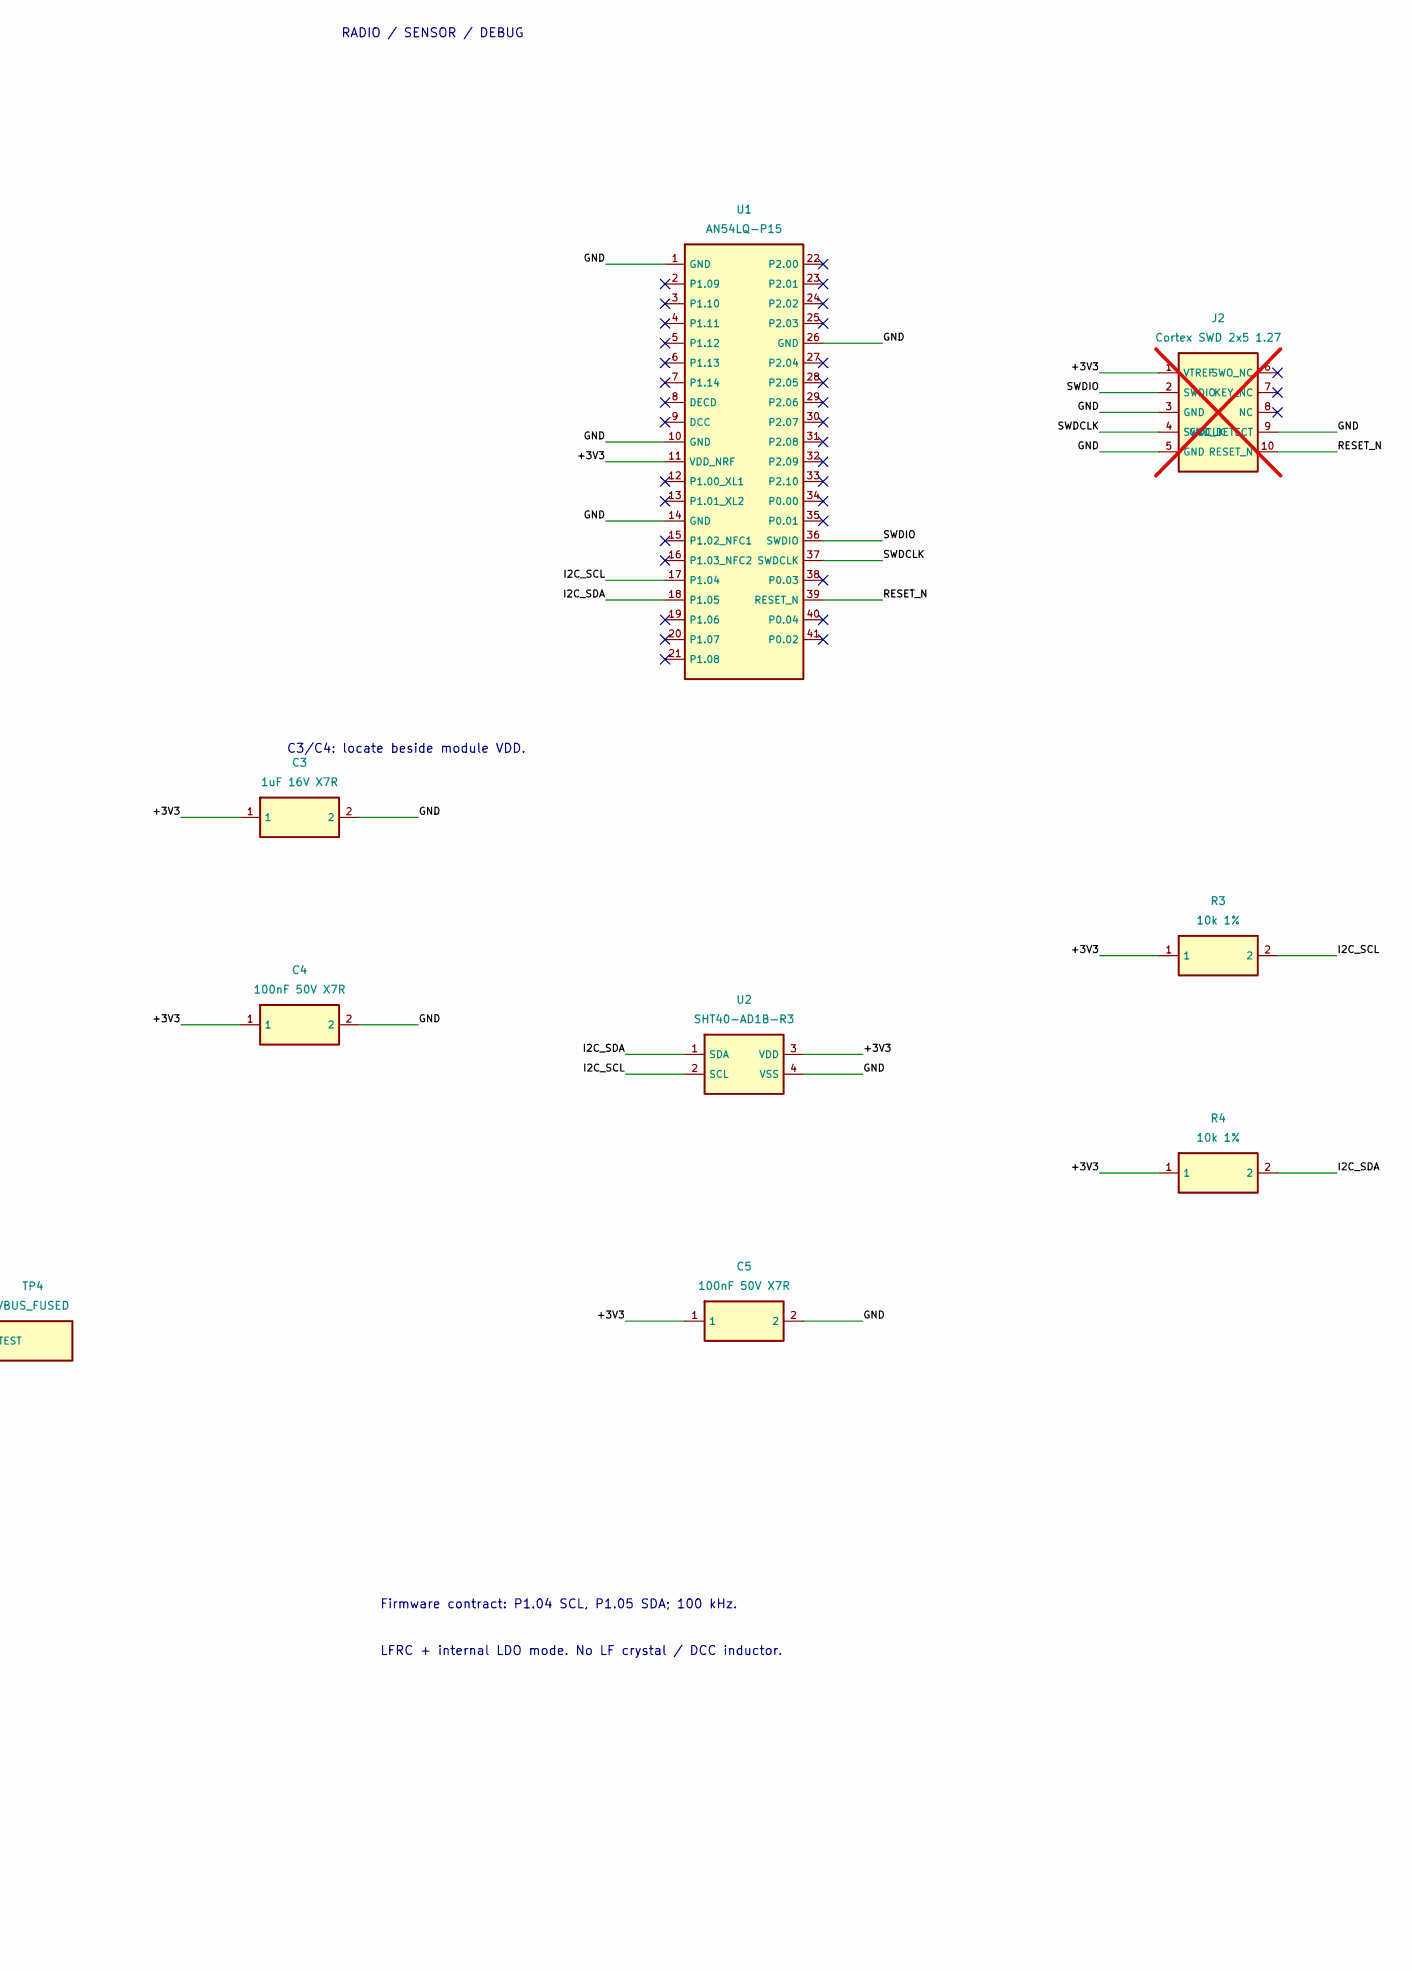
[picture p34: schematic room_sensor.kicad_sch, Room sensor A3 - protected power engineering draft, part in row 1, column 2]

Parts:
C1: 2.2uF 25V X7R; C_0805; MPN C2012X7R1E225K125AB
C2: 4.7uF 10V X7R; C_0805; MPN C2012X7R1A475K125AC
C3: 1uF 16V X7R; C_0603; MPN C1608X7R1C105K080AC
C4, C5: 100nF 50V X7R; C_0603; MPN C1608X7R1H104K080AA
D1: TPD1E10B06DYAR; SOD523; MPN TPD1E10B06DYAR
F1: 200mA hold PTC; PTC_1812; MPN MF-MSMF020-2
J1: USB4105-GF-A; USB4105_Custom; MPN USB4105-GF-A
J2: Cortex SWD 2x5 1.27; SWD_2x5_1p27; MPN DNP: pogo or header selected later; not fitted
R1, R2: 5.1k 1%; R_0603; MPN RC0603FR-075K1L
R3, R4: 10k 1%; R_0603; MPN RC0603FR-0710KL
TP1: GND; TestPoint_1mm; MPN PCB copper feature
TP2: +3V3; TestPoint_1mm; MPN PCB copper feature
TP3: RESET_N; TestPoint_1mm; MPN PCB copper feature
TP4: VBUS_FUSED; TestPoint_1mm; MPN PCB copper feature
U1: AN54LQ-P15; AN54LQ_P15_DRAFT; MPN MD-240A8-002
U2: SHT40-AD1B-R3; SHT40_DFN4; MPN SHT40-AD1B-R3
U3: LT1761-3.3; LT1761_TSOT23_5; MPN LT1761IS5-3.3#TRMPBF
U4: TPD2E2U06DCKR; SC70_3; MPN TPD2E2U06DCKR

Connections:
/+3V3: C2.1, C3.1, C4.1, C5.1, J2.1 (VTREF), R3.1, R4.1, TP2.1, U1.11 (VDD_NRF), U2.3 (VDD), U3.5 (OUT)
/CC1: J1.A5 (CC1), R1.1, U4.1 (IO1)
/CC2: J1.B5 (CC2), R2.1, U4.2 (IO2)
/GND: C1.2, C2.2, C3.2, C4.2, C5.2, D1.2 (GND), J1.A1_B12 (GND), J1.B1_A12 (GND), J1.S1 (SHELL), J2.3 (GND), J2.5 (GND), J2.9 (GND_DETECT), R1.2, R2.2, TP1.1, U1.1 (GND), U1.10 (GND), U1.14 (GND), U1.26 (GND), U2.4 (VSS), U3.2 (GND), U4.3 (GND)
/I2C_SCL: R3.2, U1.17 (P1.04), U2.2 (SCL)
/I2C_SDA: R4.2, U1.18 (P1.05), U2.1 (SDA)
/RESET_N: J2.10 (RESET_N), TP3.1, U1.39 (RESET_N)
/SWDCLK: J2.4 (SWDCLK), U1.37 (SWDCLK)
/SWDIO: J2.2 (SWDIO), U1.36 (SWDIO)
/VBUS_FUSED: C1.1, D1.1 (IO), F1.2 (OUT), TP4.1, U3.1 (IN), U3.3 (SHDN)
/VBUS_RAW: F1.1 (IN), J1.A4_B9 (VBUS), J1.B4_A9 (VBUS)

Notes on the sheet:
POWER / USB-C 5 V ONLY
RADIO / SENSOR / DEBUG
C3/C4: locate beside module VDD.
Firmware contract: P1.04 SCL, P1.05 SDA; 100 kHz.
LFRC + internal LDO mode. No LF crystal / DCC inductor.
USB data and SBU pins are intentionally unconnected. CC1 and CC2 each have their own Rd.
J2 is DNP: VTref is a sense output from this board. Power only through USB.
U1: Raytac v1.2 pinout and RF reviewed. A3 engineering exports only; no production release.
Protection ratings are component ratings; board ESD, inrush and fault response are not validated.
A3 U3: LT1761-3.3. SHDN tied to IN; BYP open. 50 mA design load budget; verify input headroom.

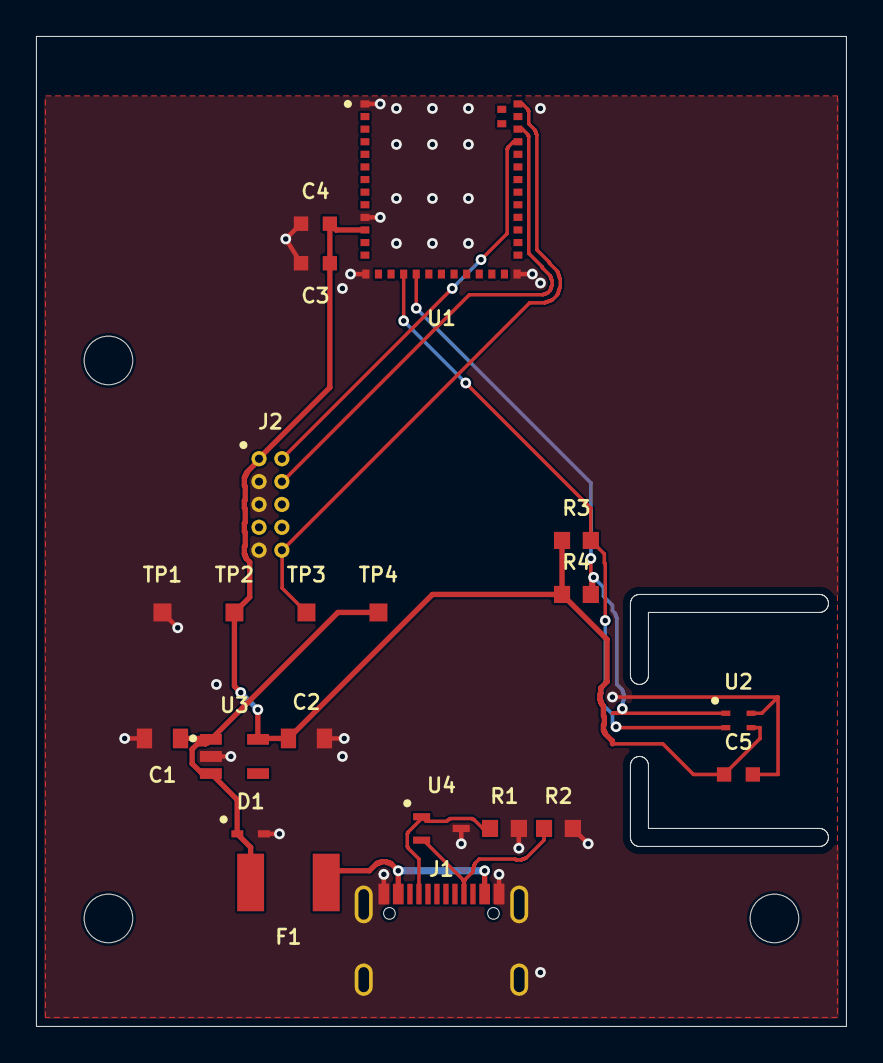
[picture p35: board room_sensor.kicad_pcb from above]

Board: 2 copper layers, 45.0 x 55.0 mm, 24 parts (0 on the bottom side), 11 nets.

Other parts of the board:
H1, H2, H3: MountingHole_2.7
