arrow53/RoomTempHumidity/(commit log)

2026-10-11 Prepare room temperature and humidity project source and design overview
    [BOM-10-boards.csv, BOM.csv, DNP-and-board-features.csv, assembly_collision_checks.scad, base_PROVISIONAL.stl, case_lid_PROVISIONAL.stl, case_nut_PROVISIONAL.stl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]
2026-10-11 Show angled populated PCB render and simplify protocol description
2026-10-11 Publish Revision C base enclosure CAD and print documentation
    [assembled_enclosure.step, enclosed_body.stl, enclosed_case.scad, fastener_coupon.step, fastener_coupon.stl, feet_45_print_two.stl, fit_coupon.stl, front_bezel.step]
